ahnaafjim/Half-life-musical-instrument/BOM_Guitar-pre-amp_2026-10-26.csv

ID | Name | Designator | Footprint | Quantity | Manufacturer Part | Manufacturer | Supplier | Supplier Part | Price
1 | 4.7uF | C1 | CAP-TH_BD5.0-P2.00-D0.8-FD | 20 | ERS1EM470D11OT | AISHI(艾华集团) | LCSC | C106650 | 0.023
2 | 47uF | C2 | CAP-TH_BD5.0-P2.00-D0.8-FD | 20 | ERS1EM470D11OT | AISHI(艾华集团) | LCSC | C106650 | 0.023
3 | 0.1u | C3 | C0603 | 20 | CC0805KRX7R9BB104 | YAGEO(国巨) | LCSC | C49678 | 0.021
4 | 0.022uF | C4 | C0603 | 50 | TCC0402X7R223K500AT | CCTC(三环) | LCSC | C380305 | 0.003
5 | 0.047uF | C5 | C0603 | 50 | CC0603KRX7R9BB473 | YAGEO(国巨) | LCSC | C107093 | 0.008
6 | 10uF | C6 | CAP-TH_BD5.0-P2.00-D0.8-FD | 20 | ERS1EM470D11OT | AISHI(艾华集团) | LCSC | C106650 | 0.023
7 | PJ-320D | CN1,CN2 | AUDIO-SMD_PJ-320D-1 | 10 | PJ-320D | SHOU HAN(首韩) | LCSC | C431535 | 0.054
8 | 1N5819_C49318088 | D1 | DO-41_BD2.4-L4.7-P8.70-D0.8-RD | 20 | 1N5819 | luJing(鲁晶) | LCSC | C49318088 | 0.024
9 | DC-005-25A | DC2 | DC-IN-TH_DC005 | 5 | DC-005-25A | 韩国韩荣 | LCSC | C136715 | 0.156
10 | 2.2M | R1 | R0603 | 50 | ESR03EZPF2204 | ROHM(罗姆) | LCSC | C2103911 | 0.018
11 | 1M | R2 | R0603 | 20 | RT0603BRD071ML | YAGEO(国巨) | LCSC | C326730 | 0.036
12 | 10kΩ | R3 | RES-TH_RK09K1130A6S | 1 | RK09K1130A6S | ALPSALPINE(阿尔卑斯阿尔派) | LCSC | C209770 | 0.597
13 | 100kΩ | R4,R8 | RES-ADJ-TH_PDB181-K420K-XXXB | 2 | PDB181-K220K-104B | BOURNS | LCSC | C6357164 | 2.242
14 | 100k | R5,R6 | R0603 | 20 | RT0603BRD07100KL | YAGEO(国巨) | LCSC | C122538 | 0.028
15 | 100 | R7 | R0603 | 20 | RT0603BRD07100RL | YAGEO(国巨) | LCSC | C122970 | 0.032
16 | 10k | R9 | R0603 | 20 | RT0603BRD0710KL | YAGEO(国巨) | LCSC | C95204 | 0.033
17 | TL071IDT | U2 | SO-8_L4.9-W3.9-P1.27-LS6.0-BL | 1 | TL071IDT | ST(意法半导体) | LCSC | C2652251 | 0.746
