ahnaafjim/Half-life-musical-instrument/enclosure 3d prints/Part Studio 3.stl

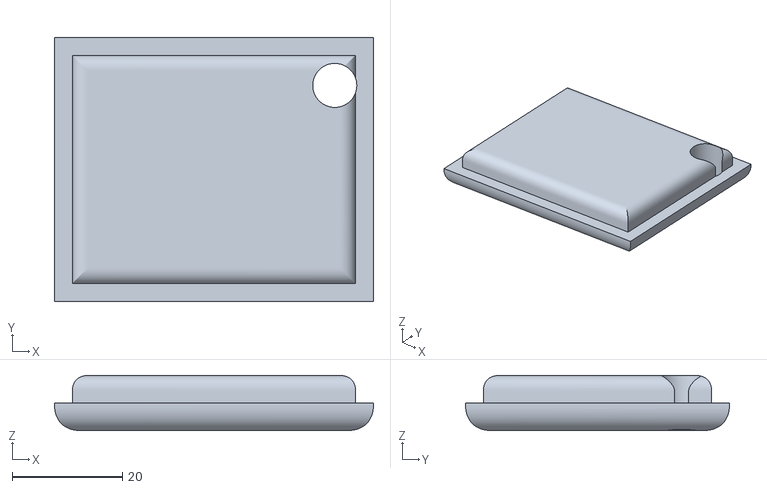
[picture p4: CAD file, 2026-10-25]
enclosure 3d prints/Part Studio 3.stl
58.0 x 48.0 x 10.0
