ahnaafjim/Half-life-musical-instrument/enclosure 3d prints/Part Studio 1.stl

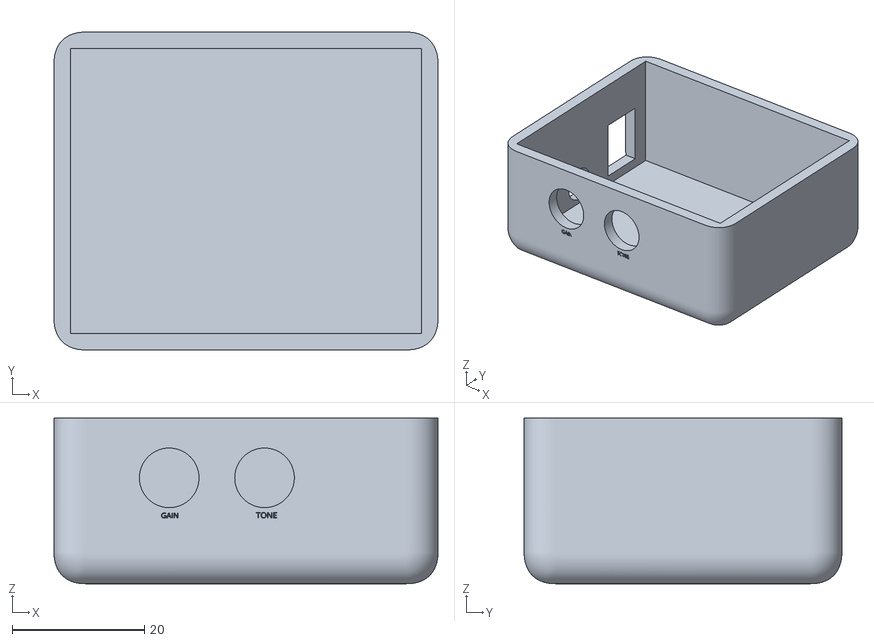
[picture p5: CAD file, 2026-10-25]
enclosure 3d prints/Part Studio 1.stl
58.0 x 48.0 x 25.0
