ahnaafjim/Half-life-musical-instrument/enclosure 3d prints/Part Studio 2.stl

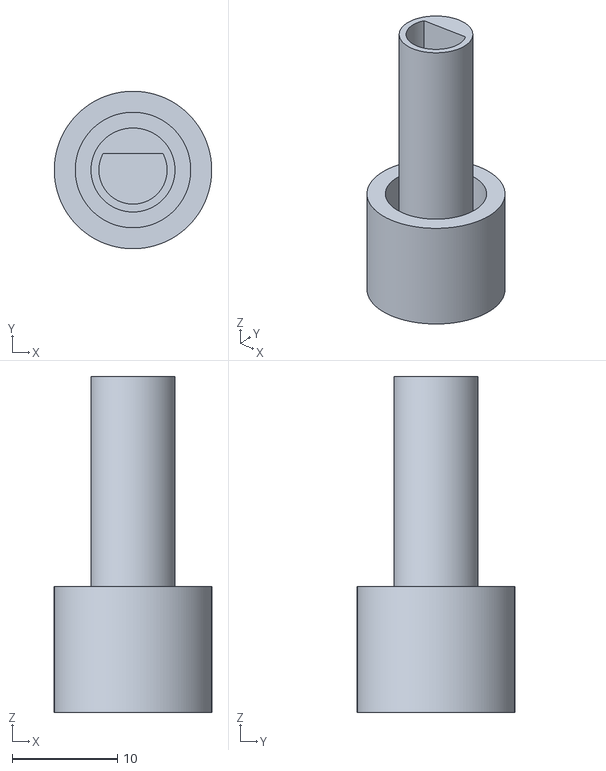
[picture p6: CAD file, 2026-10-25]
enclosure 3d prints/Part Studio 2.stl
15.0 x 15.0 x 32.0
