ahnaafjim/Half-life-musical-instrument/(list of files, drawings)

Other design files:
PCB_PCB_Guitar-pre-amp_2026-10-26.json
SCH_Guitar-pre-amp_2026-10-25.json
